CalRL/projet-Panneau-Solaire/docs/Cd MAT electronique PANSOL (Panneau solaire camping car)/Site INTERNET JCN/panneau/images/image011.jpg

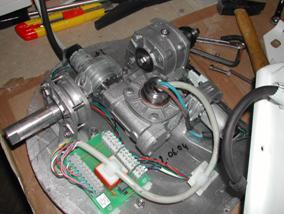
docs/Cd MAT electronique PANSOL (Panneau solaire camping car)/Site INTERNET JCN/panneau/images/image011.jpg
