CalRL/projet-Panneau-Solaire/docs/Cd MAT electronique PANSOL (Panneau solaire camping car)/documentation pdf/notice alden.pdf

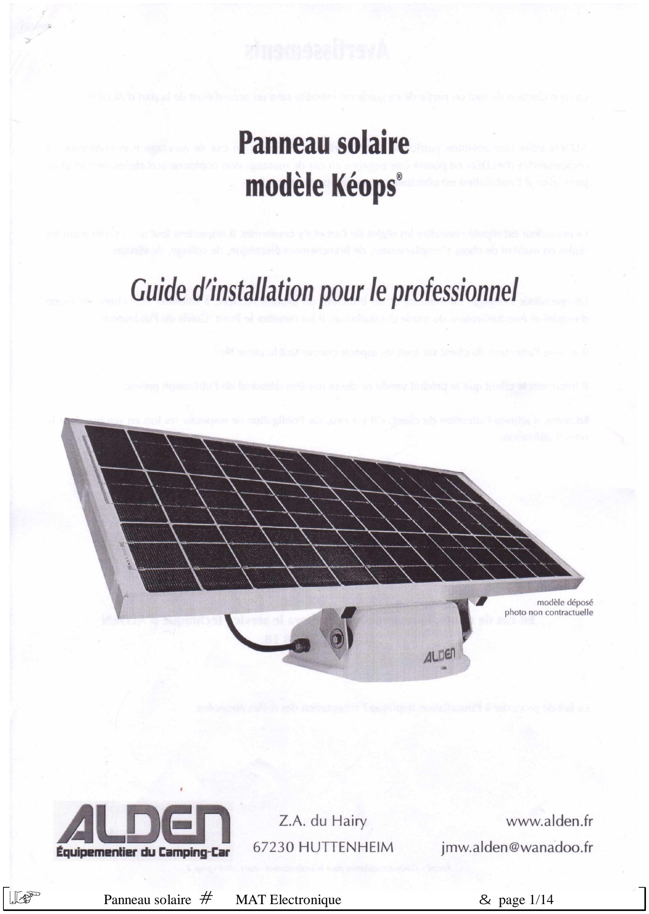
[picture p5: page 1]

Panneau solaire # MAT Electronique | & page 1/14

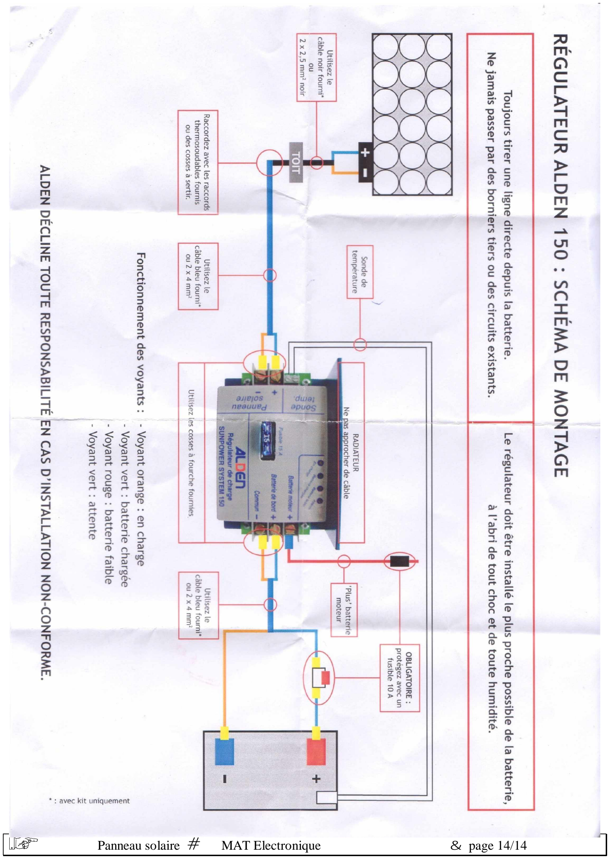
[picture p6: page 14]
