CalRL/projet-Panneau-Solaire/docs/Cd MAT electronique PANSOL (Panneau solaire camping car)/Site INTERNET JCN/panneau/fichiers/ccs_icd.pdf

Développement en C avec CCS et ICD.

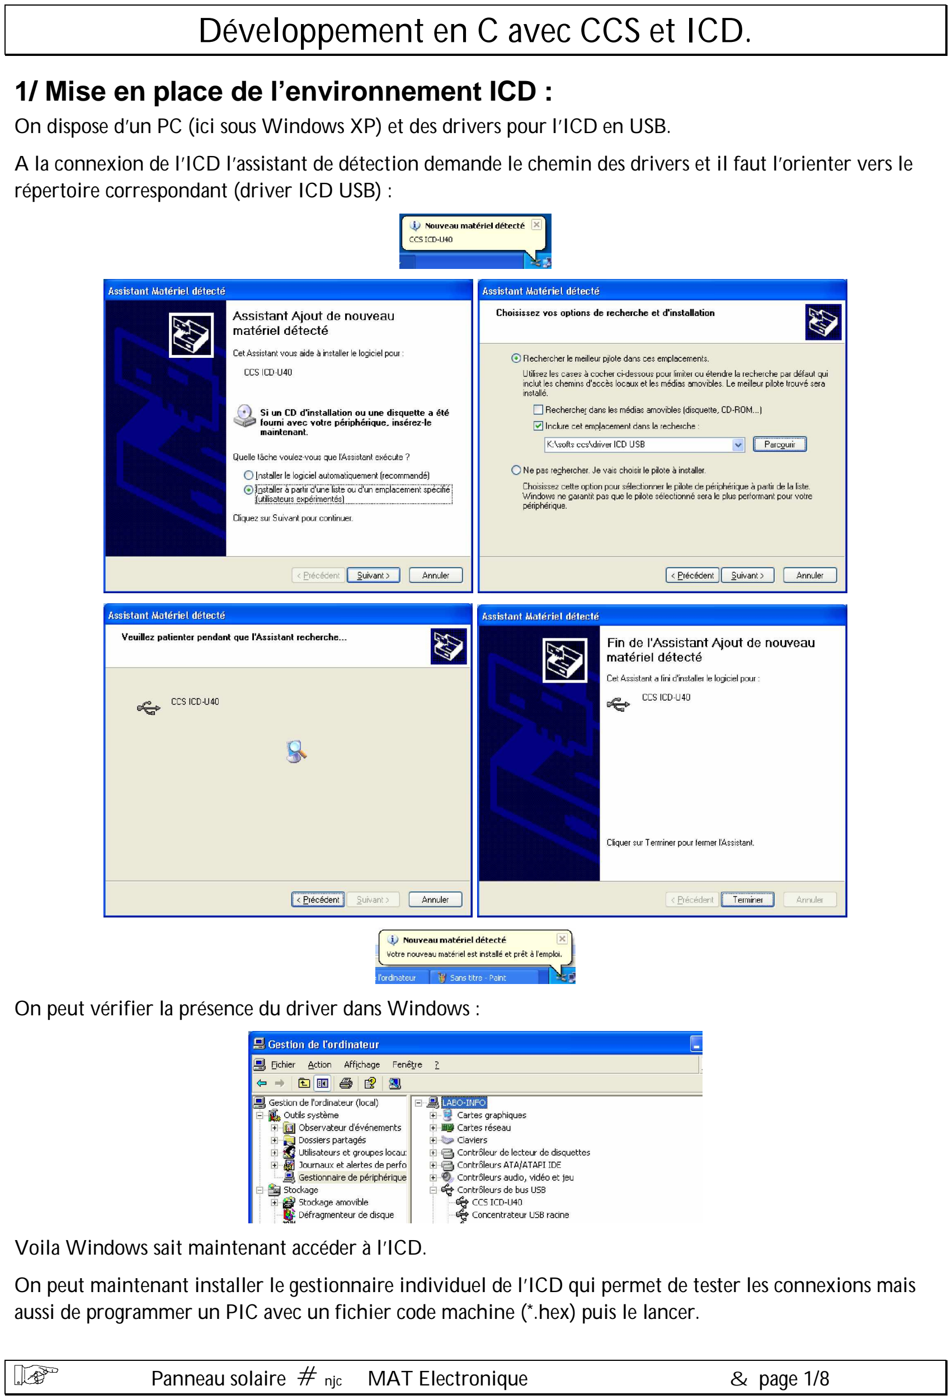
[picture p7: page 1]

Panneau solaire #njc | MAT Electronique | & page 1/8

1/ Mise en place de l’environnement ICD :
On dispose d’un PC (ici sous Windows XP) et des drivers pour l’ICD en USB.
A la connexion de l’ICD l’assistant de détection demande le chemin des drivers et il faut l’orienter vers le répertoire correspondant (driver ICD USB) :

On peut vérifier la présence du driver dans Windows :

Voila Windows sait maintenant accéder à l’ICD.
On peut maintenant installer le gestionnaire individuel de l’ICD qui permet de tester les connexions mais aussi de programmer un PIC avec un fichier code machine (*.hex) puis le lancer.

On lance le programme : icdu.exe et une fois l’installation terminée on obtient l’icône du bureau :

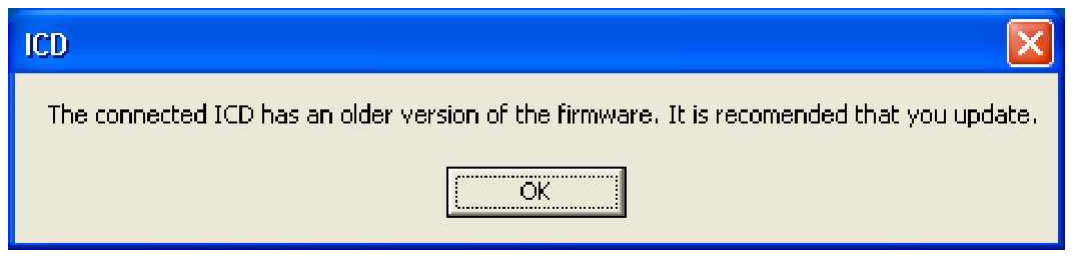
[picture p8: figure]

On peut lancer le programme :
Cette fenêtre indique que logiciel contenu dans l’ICD est une version plus ancienne que celle du gestionnaire Windows, on accepte la mise à jour.

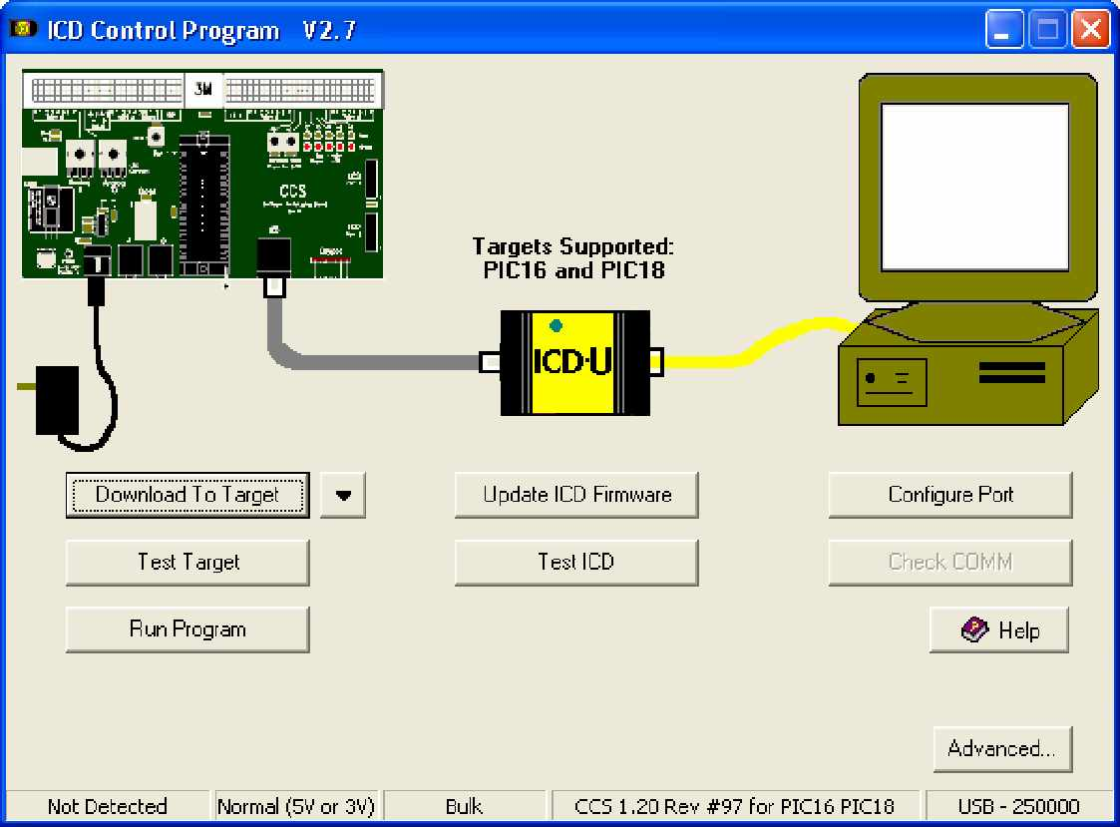
[picture p9: figure]

La version du gestionnaire est ici V2.7 alors que le firmware est CCS 1.20

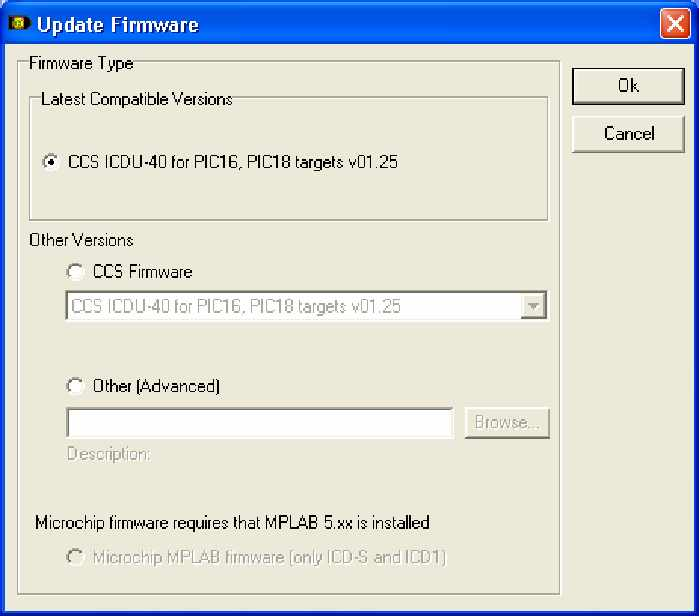
[picture p10: figure]

Le bouton Update ICD Firmware permet la mise à jour :

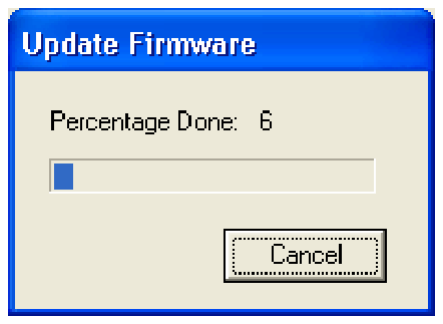
[picture p11: figure]

On accepte :

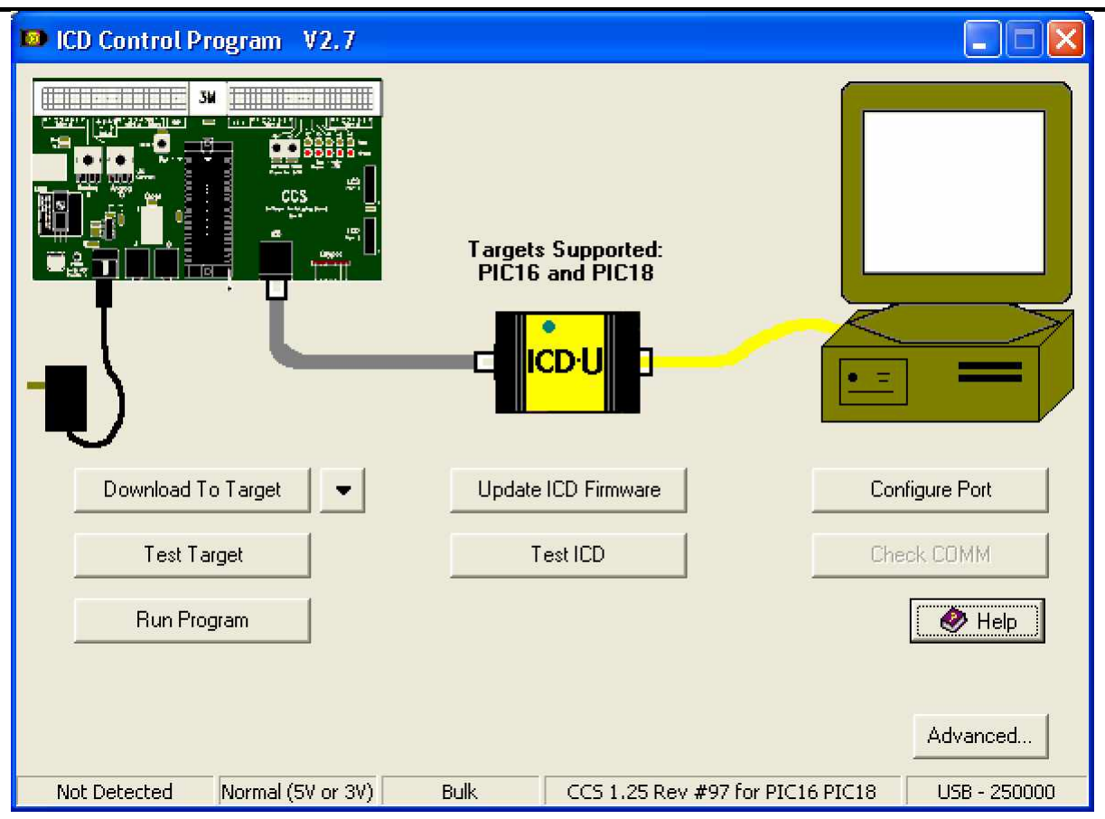
[picture p12: figure]

On obtient :

On peut alors tester l’ICD avec Test ICD :

La cible (target) n’étant pas connecté, on obtient :

Si on connecte une carte cible, on obtient :
Nous pouvons alors utiliser les boutons :
- Download to target pour programmer le PIC de la cible
- Run program pour lancer un programme. On pourra arrêter le programme avec | où
tout simplement débrancher l’ICD de la cible pour utiliser la cible.

2/ Mise place de l’environnement de développement.
Il faut installer le compilateur C en lançant le programme.

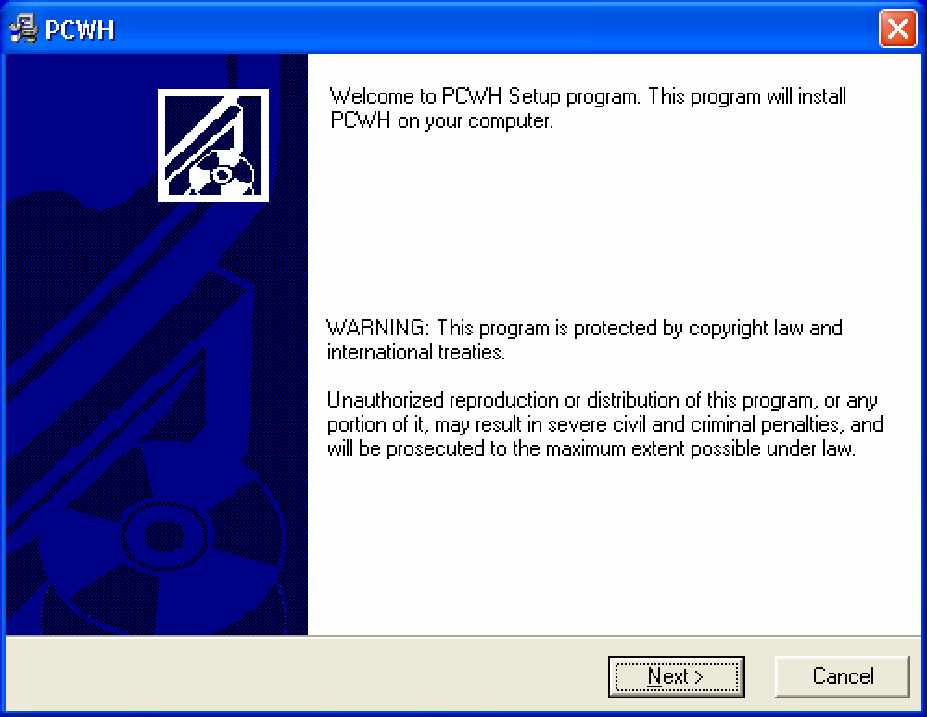
[picture p13: figure]

On accepte le répertoire | qui contient déjà le gestionnaire de l’ICD.

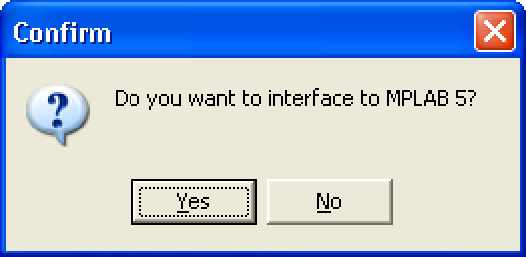
[picture p14: figure]

Si on utilise pas MPLAB de Microchip on répond No :

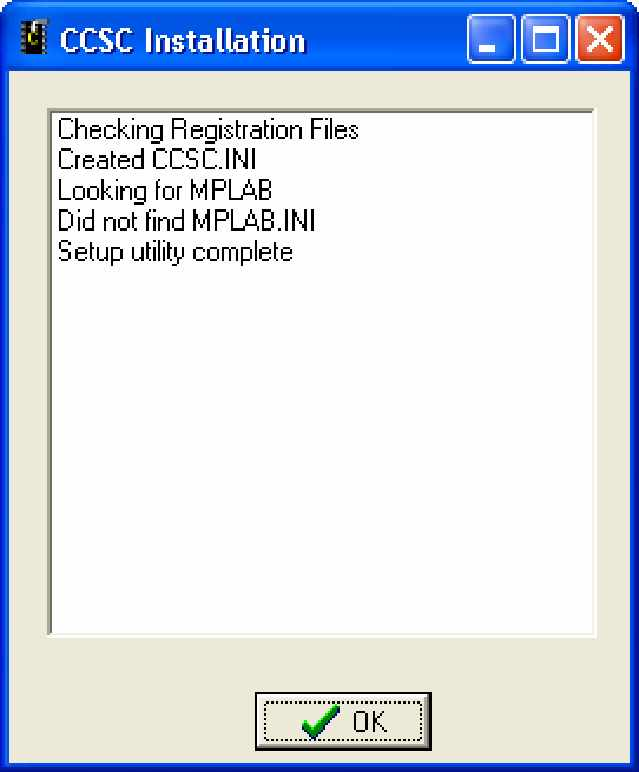
[picture p15: figure]

L’installation est terminée :

L’icône | permet de lancer l’environnement de développement et le menu Help>About permet de
voir la version des outils :

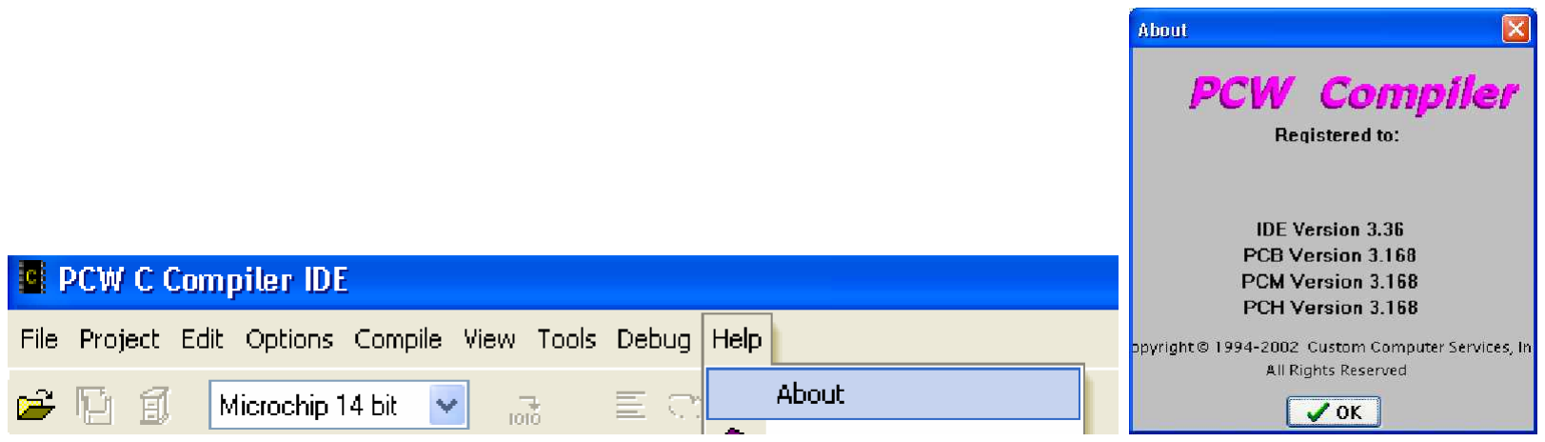
[picture p16: figure]

Nous voilà prêt pour un premier projet :

On choisit l’assistant PIC Wizard :
On choisit une localisation pour le projet (répertoire) puis un nom (main).

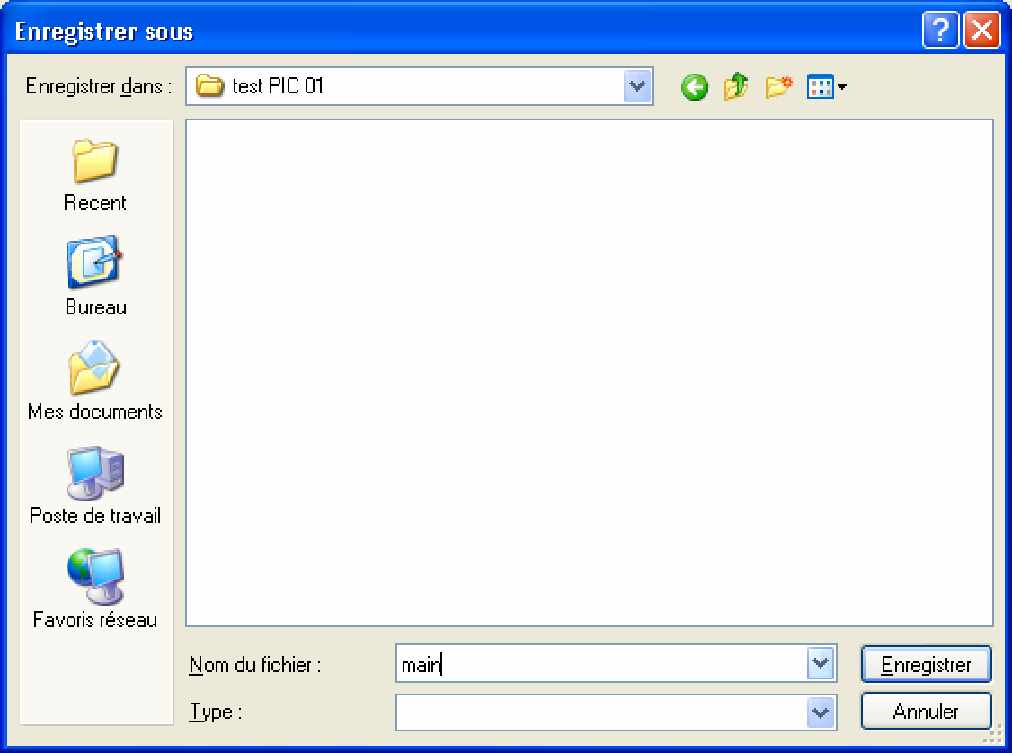
[picture p17: figure]

On choisit les caractéristiques (processeur, fréquence …)

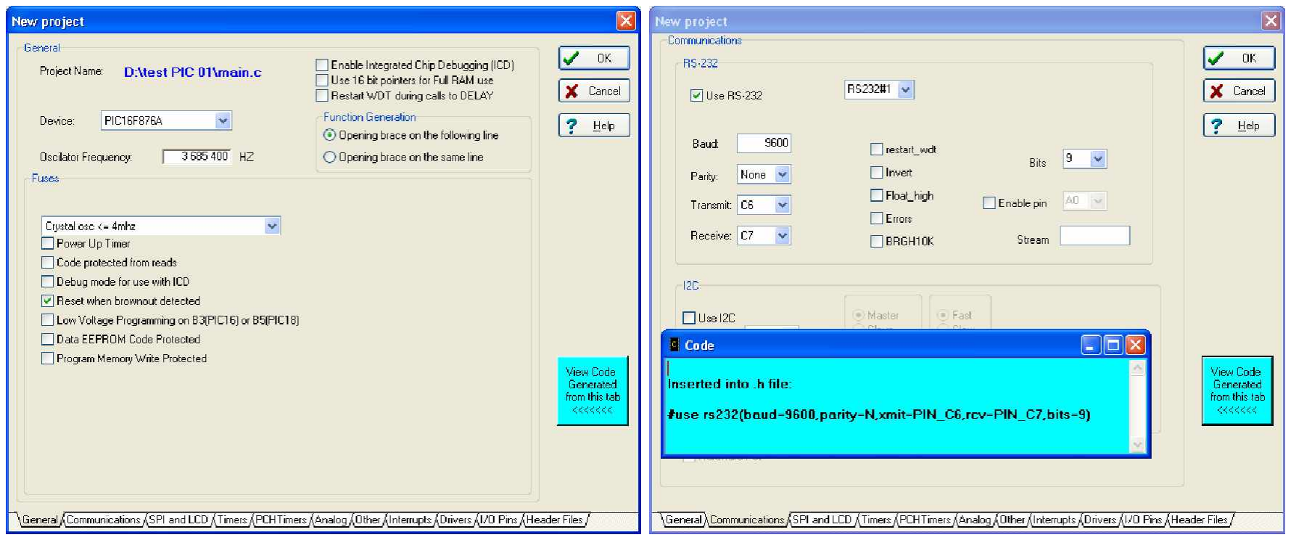
[picture p18: figure]

Le fait de cocher ou non des options va inclure des options pour la configuration du PIC lors de sa programmation.
Une fois accepté ces options on arrive au projet qui comporte 3 fichiers :

On distingue :
- main.pjt qui décrit le projet
- main.c le fichier source principal
- main.h appelé dans main.c et qui contient les options de programmation du PIC choisi.
On remarque que main.h fait appel au fichier de définition du PIC choisi. On peut réorganiser le projet et inclure les lignes de main.h dans main.c. On peut également modifier les lignes obtenues depuis l’assistant pour en ajouter, en supprimer ou les modifier.

On a :

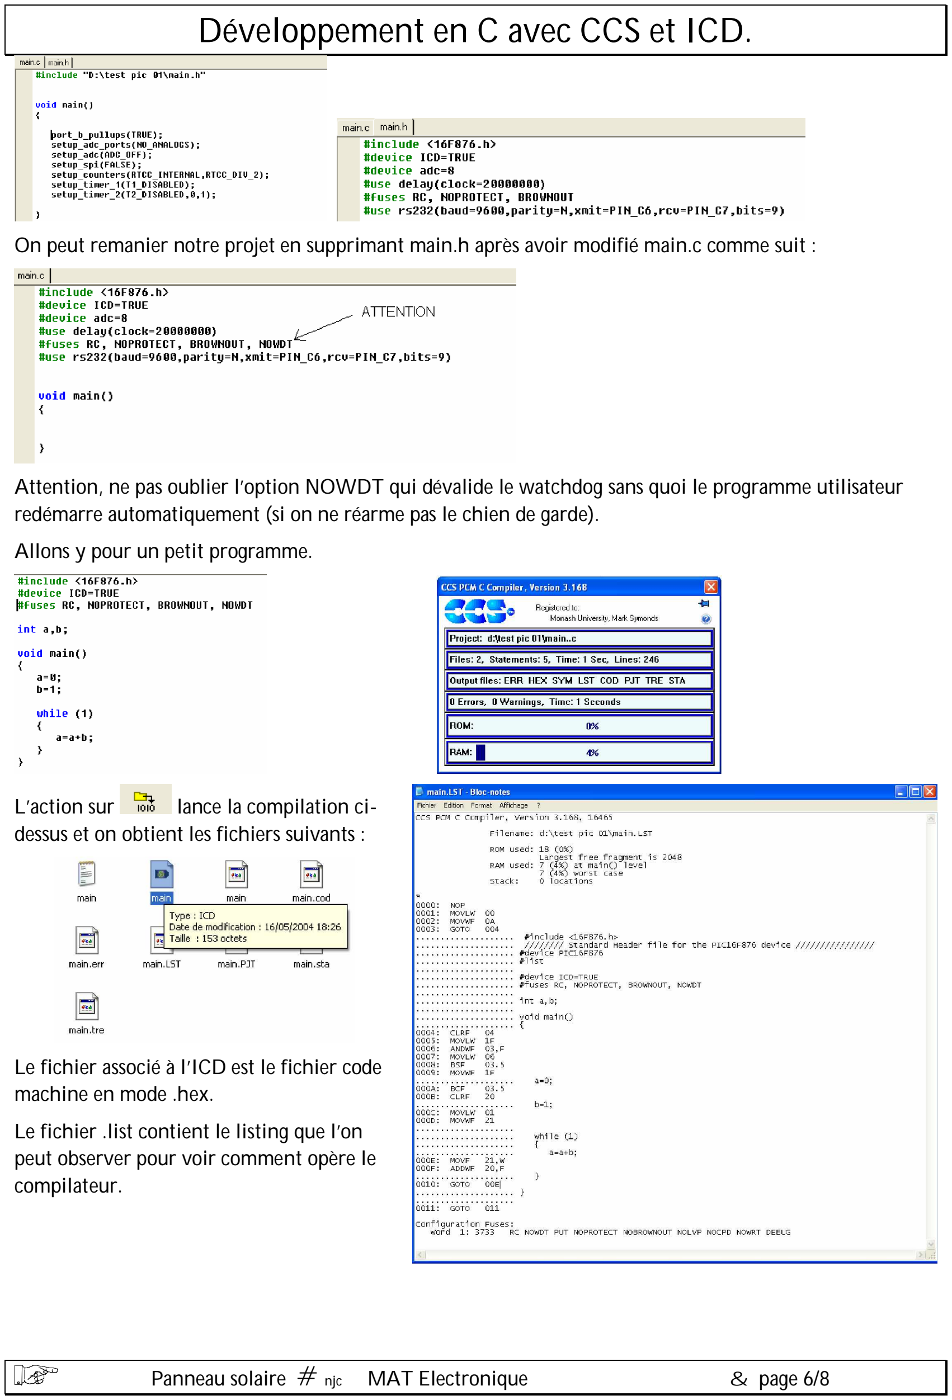
[picture p19: page 6]

On peut remanier notre projet en supprimant main.h après avoir modifié main.c comme suit :

Attention, ne pas oublier l’option NOWDT qui dévalide le watchdog sans quoi le programme utilisateur redémarre automatiquement (si on ne réarme pas le chien de garde).
Allons y pour un petit programme.

L’action sur lance la compilation ci-dessus et on obtient les fichiers suivants :

Le fichier associé à l’ICD est le fichier code machine en mode .hex.
Le fichier .list contient le listing que l’on peut observer pour voir comment opère le compilateur.

3/ Implantation du programme dans la cible.
Pour implanter ce programme sur une cible, on peut utiliser directement la cible connecté à l’ICD. On a deux cas de figure :

a/ Programmation directe

Le programme fonctionne et on désire programmer la cible ; on utilise directement l’ICD pour programmer la cible et lancer le programme. Si le programme fonctionne comme il faut, une fois l’ICD déconnecté, c’est terminé.

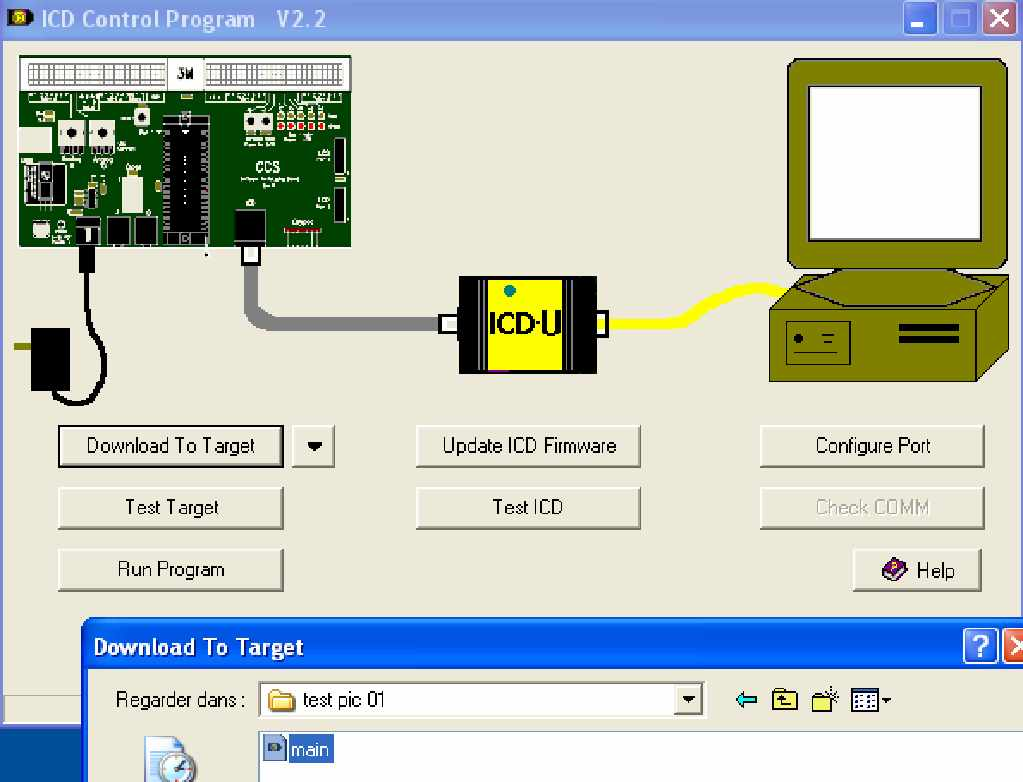
[picture p20: figure]

b/ Test et implantation.
Si l’on désire débugger le programme, on utilise, après avoir connecté la cible et l’ICD, directement

dans CCS

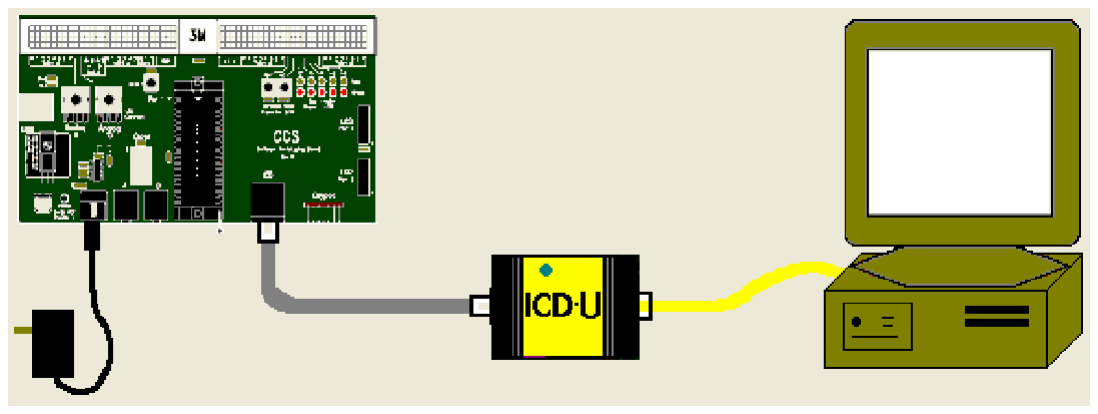
[picture p21: figure]
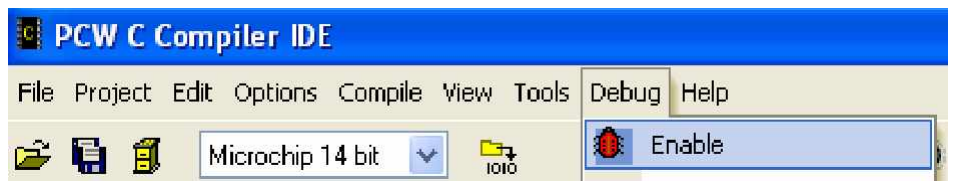
[picture p22: figure]

Si la connexion s’effectue correctement, le programme est téléchargé dans la mémoire du PIC, et le débuggeur donne la main en affichant ready.

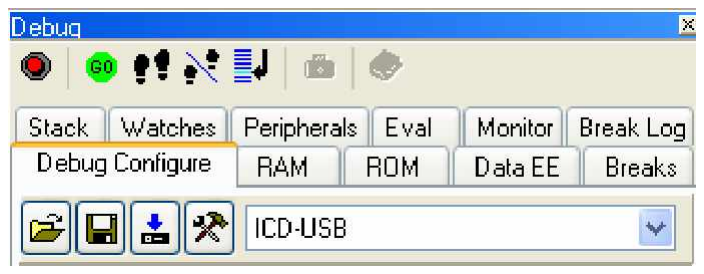
[picture p23: figure]

Si la connexion ne marche pas, il faut vérifier, dans les options du PIC, par exemple, l’horloge qui doit correspondre à celle de la cible (XT pour quartz inférieur à 4 MHz , HS ou RC).

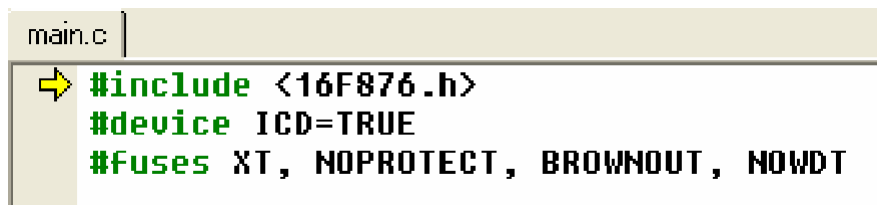
[picture p24: figure]

On peut utiliser les boutons de commande pour commander le test d’un programme :

permet de faire un reset du programme.
permet de lancer un programme en permanence ou jusqu’à un point d’arrêt.

permet de faire du pas à pas en rentrant dans les fonctions.
permet de faire du pas à pas sans rentrer dans les fonctions.
permet de lancer un programme jusqu’à la ligne où l’on a placé le point d’insertion dans le fichier source.
Pour placer un point d’insertion, on positionne le curseur à l’endroit voulu dans le fichier source, puis dans la fenêtre break du débuggeur, on clique sur le bouton plus. Le point rouge indique alors le point d’arrêt. Un seul point d’arrêt est autorisé et le bouton moins permet de supprimer un point d’arrêt (après l’avoir sélectionné).

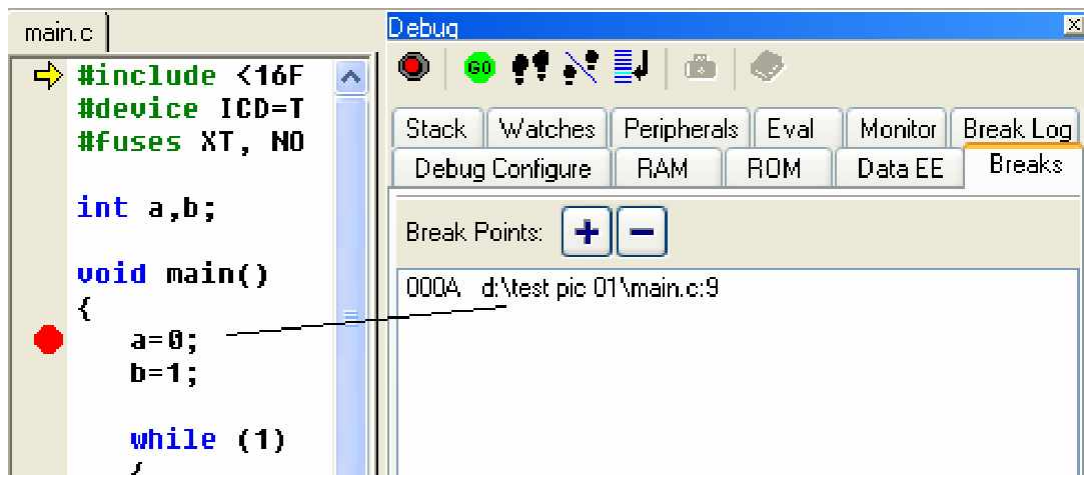
[picture p25: figure]
