CalRL/projet-Panneau-Solaire/docs/deprecated/Cahier Des Charges.docx

| Fonctions | Critères | Niveaux
FP1 | Alimenter une carte raspberry pi | Type d’alimentation Charge h24
FP2 | Alimenter une batterie | Type d’alimentation Charge h24
FC1 | L’objet doit résister au climat | Durabilité et matériaux
FC2 | L’objet doit être esthétique | Forme, couleur
FC3 | L’objet doit avoir un prix raisonnable et compétitif | Coût
FC4 | L’objet doit respecter l’environnement et contribuer au développement durable | Procède de recyclage
FC5 | L’objet ne doit pas être trop grand ou trop lourd | Dimensions et Poids

Cahier des charges
