CalRL/projet-Panneau-Solaire/docs/deprecated/Doc.docx

Marwane Salhi

Ethan Dahi Germain

Callum Burns-O’Regan

Projet SIN

Le groupe a choisi de prendre inspiration sur le deuxième projet, on va créer un site web et l’héberger sur une raspberry pi qui sera alimenté par un panneau solaire. Le panneau solaire s’orientera sur deux axes en fonction du soleil, grâce a une camera, et des calculs mathématiques.
