CalRL/projet-Panneau-Solaire/docs/Cd MAT electronique PANSOL (Panneau solaire camping car)/Documentations/notice alden page 12.jpg

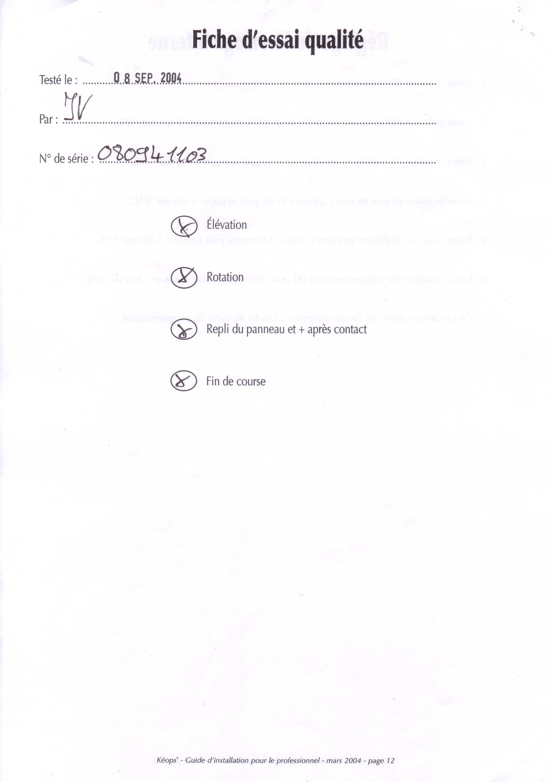
docs/Cd MAT electronique PANSOL (Panneau solaire camping car)/Documentations/notice alden page 12.jpg
