CalRL/projet-Panneau-Solaire/docs/Cd MAT electronique PANSOL (Panneau solaire camping car)/photos & média/copie écran/analyseur 2.JPG

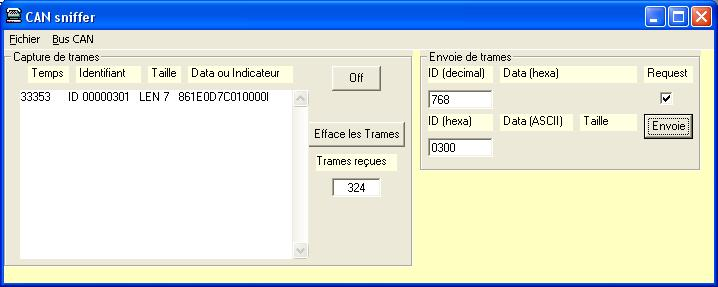
docs/Cd MAT electronique PANSOL (Panneau solaire camping car)/photos & média/copie écran/analyseur 2.JPG
