CalRL/projet-Panneau-Solaire/docs/Cd MAT electronique PANSOL (Panneau solaire camping car)/photos & média/copie écran/can sniffer.JPG

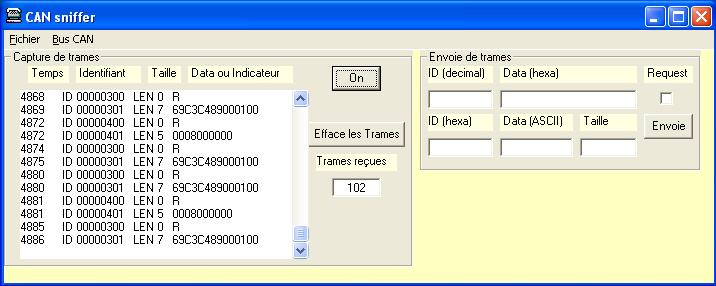
docs/Cd MAT electronique PANSOL (Panneau solaire camping car)/photos & média/copie écran/can sniffer.JPG
