CalRL/projet-Panneau-Solaire/docs/Cd MAT electronique PANSOL (Panneau solaire camping car)/photos & média/mecanique/DSCN0007.JPG

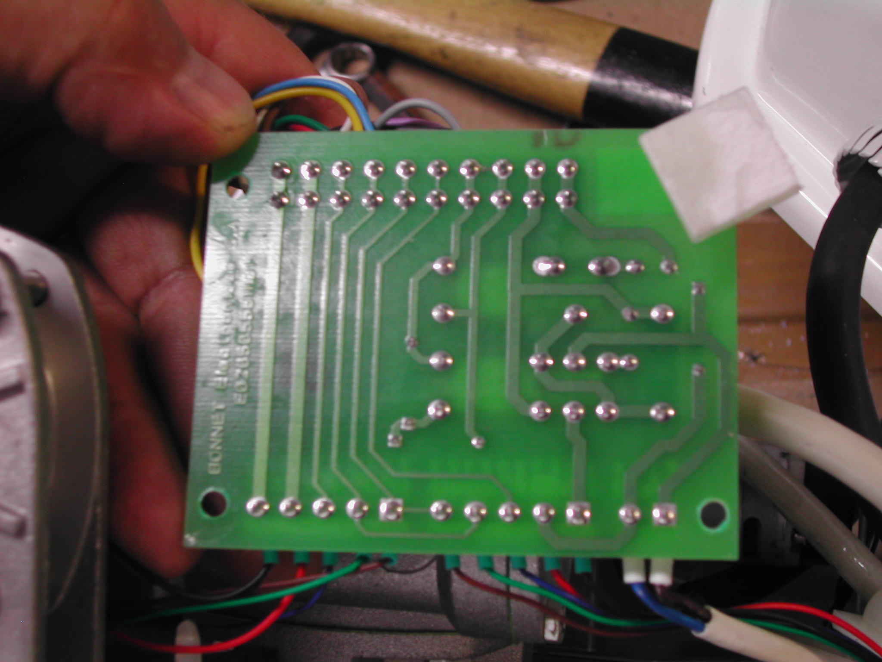
docs/Cd MAT electronique PANSOL (Panneau solaire camping car)/photos & média/mecanique/DSCN0007.JPG
