CalRL/projet-Panneau-Solaire/docs/Cd MAT electronique PANSOL (Panneau solaire camping car)/photos & média/panneau (2).JPG

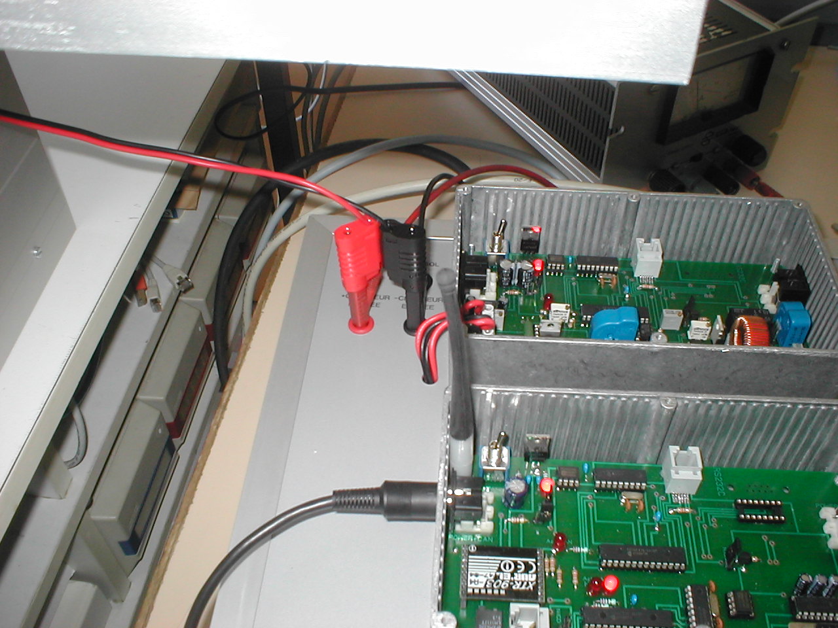
docs/Cd MAT electronique PANSOL (Panneau solaire camping car)/photos & média/panneau (2).JPG
