CalRL/projet-Panneau-Solaire/docs/Cd MAT electronique PANSOL (Panneau solaire camping car)/photos & média/panneau (6).JPG

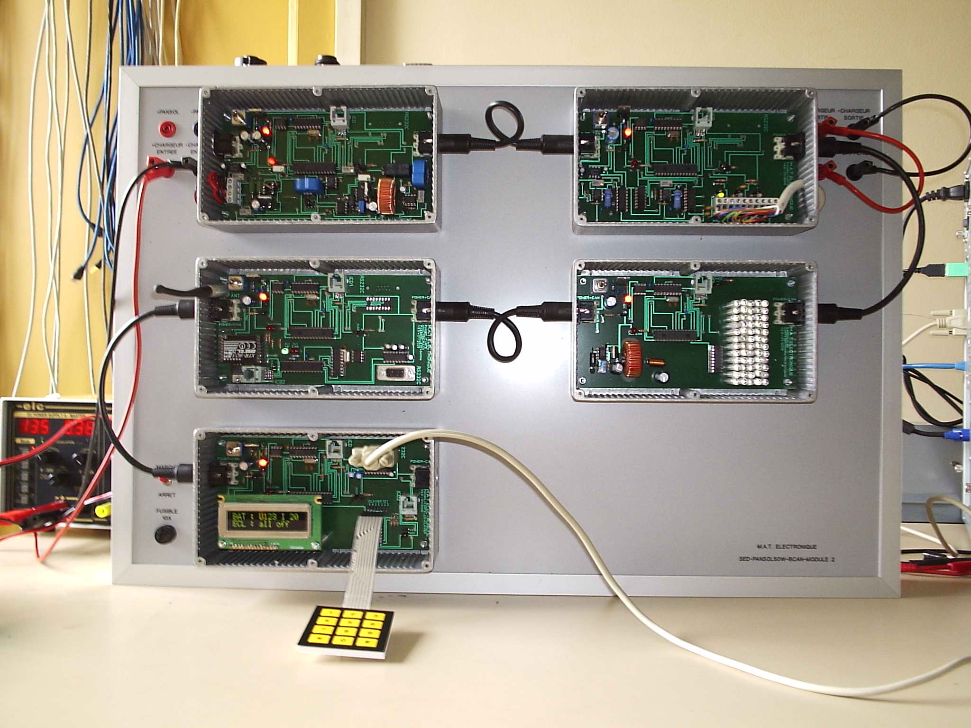
docs/Cd MAT electronique PANSOL (Panneau solaire camping car)/photos & média/panneau (6).JPG
