CalRL/projet-Panneau-Solaire/docs/Cd MAT electronique PANSOL (Panneau solaire camping car)/Schémas structurels des cartes électroniques/PANSOL carte captage luminosité.GIF

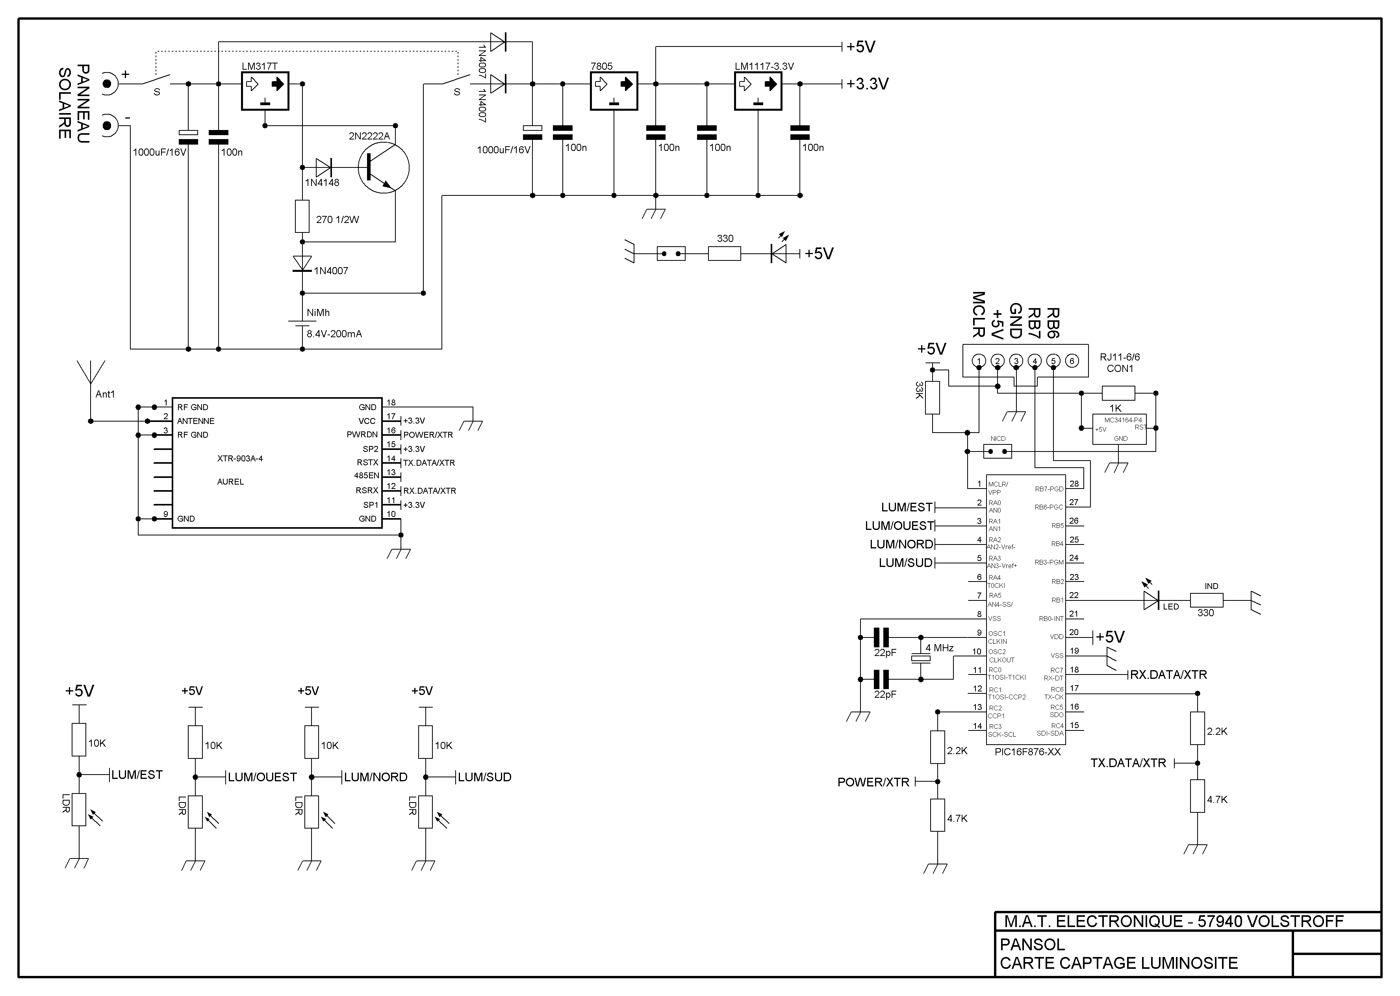
docs/Cd MAT electronique PANSOL (Panneau solaire camping car)/Schémas structurels des cartes électroniques/PANSOL carte captage luminosité.GIF
