CalRL/projet-Panneau-Solaire/docs/Cd MAT electronique PANSOL (Panneau solaire camping car)/Schémas structurels des cartes électroniques/PANSOL carte commande LCD+clavier.GIF

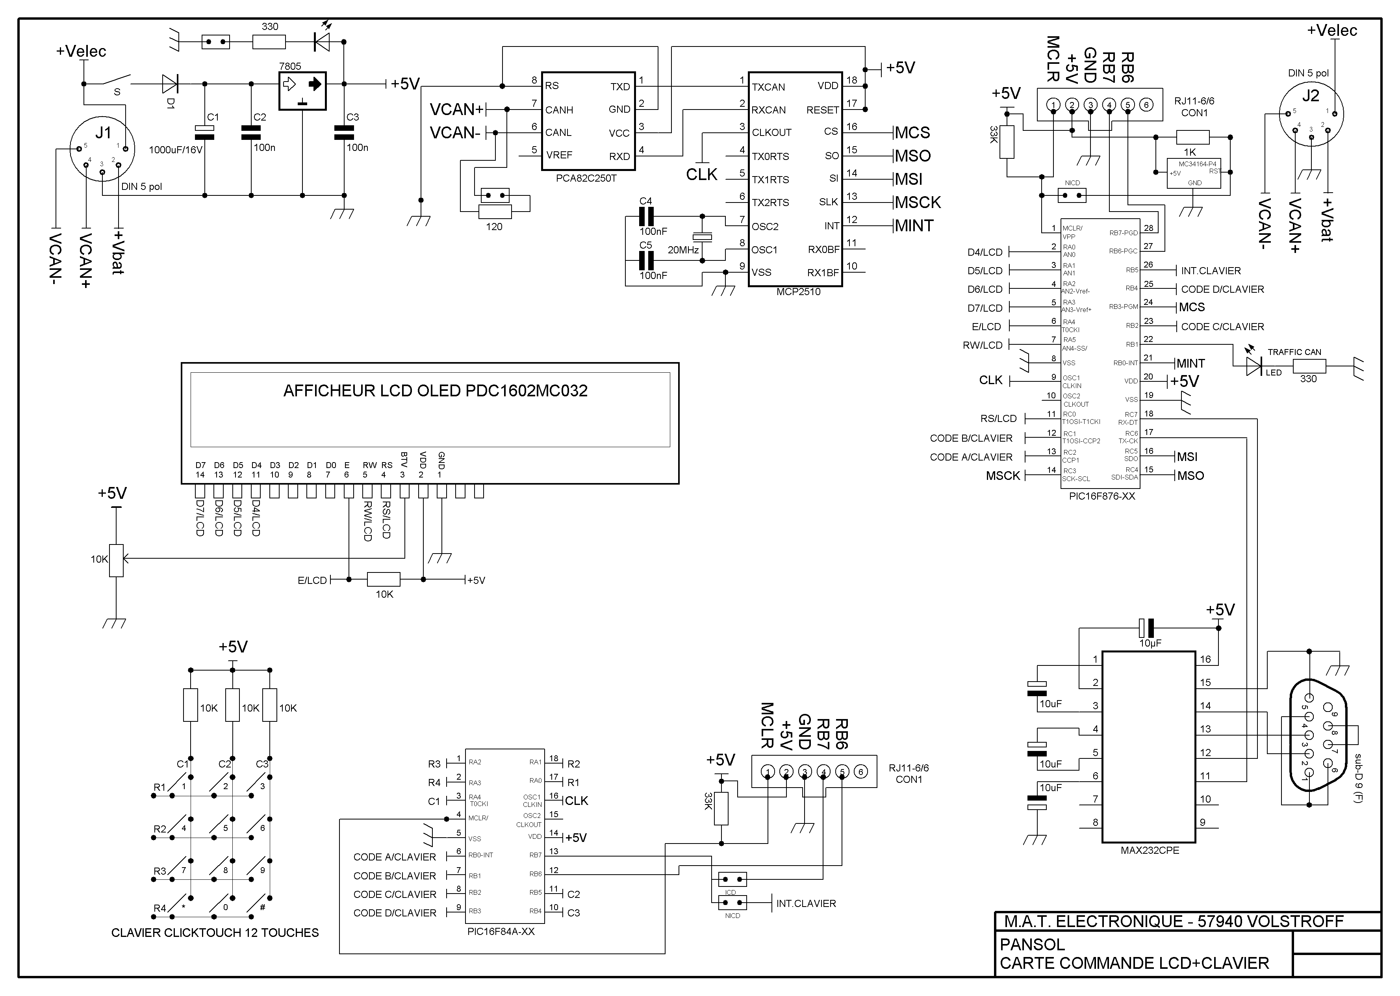
docs/Cd MAT electronique PANSOL (Panneau solaire camping car)/Schémas structurels des cartes électroniques/PANSOL carte commande LCD+clavier.GIF
