CalRL/projet-Panneau-Solaire/docs/Cd MAT electronique PANSOL (Panneau solaire camping car)/Site INTERNET JCN/afficheur/images/etuds03.jpg

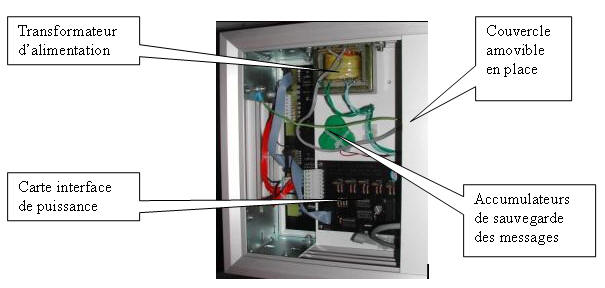
docs/Cd MAT electronique PANSOL (Panneau solaire camping car)/Site INTERNET JCN/afficheur/images/etuds03.jpg
