CalRL/projet-Panneau-Solaire/docs/Cd MAT electronique PANSOL (Panneau solaire camping car)/Site INTERNET JCN/afficheur/images/image007.gif

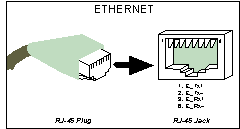
docs/Cd MAT electronique PANSOL (Panneau solaire camping car)/Site INTERNET JCN/afficheur/images/image007.gif
