CalRL/projet-Panneau-Solaire/(list of files, drawings)

Other design files:
docs/Cd MAT electronique PANSOL (Panneau solaire camping car)/mspower point 97 lecteur/VIEWER/MSPPT8VR.OLB
docs/Cd MAT electronique PANSOL (Panneau solaire camping car)/Schémas structurels des cartes électroniques/PANSOL carte anayseur+passerelle RF - v0105.LAY
docs/Cd MAT electronique PANSOL (Panneau solaire camping car)/Schémas structurels des cartes électroniques/PANSOL carte captage+RF - v0105.LAY
docs/Cd MAT electronique PANSOL (Panneau solaire camping car)/Schémas structurels des cartes électroniques/PANSOL carte chargeur+alimentation - v0105 (version pour PANSOL50W).LAY
docs/Cd MAT electronique PANSOL (Panneau solaire camping car)/Schémas structurels des cartes électroniques/PANSOL carte chargeur+alimentation - v0105 (version pour PANSOL100W++).LAY
docs/Cd MAT electronique PANSOL (Panneau solaire camping car)/Schémas structurels des cartes électroniques/PANSOL carte clavier+lcd - v0105.LAY
docs/Cd MAT electronique PANSOL (Panneau solaire camping car)/Schémas structurels des cartes électroniques/PANSOL carte matrice 60 leds - V0105.LAY
docs/Cd MAT electronique PANSOL (Panneau solaire camping car)/Schémas structurels des cartes électroniques/PANSOL carte moteur - V0105.LAY
