CalRL/projet-Panneau-Solaire/(commit log)

2022-03-18 Create Cahier Des Charges.docx
2022-04-07 Ajouté MathJS, calcul de l'azimuth avec objet JSON
